M17-Project/Exploded_Mini17/Hardware/EasyEDA/BOM_exploded_mini17_2022-10-17.csv

ID | Name | Designator | Footprint | Quantity | Manufacturer Part | Manufacturer | Supplier | Supplier Part | Price
1 | 15pF | C1,C2 | C0603 | 2 | 0603N150J500CT | Huaxin S&T | LCSC | C302056 | 0.003
2 | 47nF | C3,C4,C5,C6,C7,C8,C9,C10,C11 | C0805 | 9 | CC0805JRX7R7BB473 | YAGEO | LCSC | C520035 | 0.022
3 | 10uF | C12,C25,C57,C59 | CAP-SMD_BD4.0-L4.3-W4.3-LS5.0-FD | 4 | HV100M025B055R | CapXon | LCSC | C59931 | 0.039
4 | 100nF | C13,C14,C16,C24,C26,C36,C37,C38,C39,C40,C41,C42,C43,C46,C49,C50,C51,C52,C53,C56,C58,C60 | C0805 | 22 | 0805B104K500 | WTC | LCSC | C83055 | 0.006
5 | 1uF | C15,C17 | C0805 | 2 | UMK212BJ105KG-T | Taiyo Yuden | LCSC | C319195 | 0.032
6 | 47nF | C18,C19 | C0603 | 2 | 0603F473Z500CT | Huaxin S&T | LCSC | C302047 | 0.015
7 | 56pF | C20 | C0603 | 1 | CGA3E2C0G1H560JT0Y0N | TDK | LCSC | C338104 | 0.019
8 | 100pF | C21 | C0603 | 1 | GRM1885C1H101JA01D | MuRata | LCSC | C71664 | 0.005
9 | 10nF | C22 | C0603 | 1 | GRM188R71H103KA01D | MuRata | LCSC | C77053 | 0.004
10 | 1.5nF | C23 | C0402 | 1 | C1005X7R152KGT | Darfon Elec | LCSC | C147555 | 0.013
11 | 10nF | C27 | C0402 | 1 | GCM155R71H103KA55D | MuRata | LCSC | C91601 | 0.006
12 | 22uF | C28,C45 | CAP-SMD_BD6.3-L6.6-W6.6-FD | 2 | EEEFK1H220P | PANASONIC | LCSC | C128458 | 0.372
13 | 39pF | C29 | C0603 | 1 | TCC0603COG390J500CT | CCTC | LCSC | C376784 | 0.0029
14 | 5.1pF | C30,C31,C35 | C0402 | 3 | GJM1555C1H5R1CB01D | muRata(村田) | LCSC | C882560 | 0.014
15 | 220nF | C32 | C0603 | 1 | 0603B224K250CT | Walsin Tech Corp | LCSC | C335532 | 0.005
16 | 2.2pF | C33 | C0402 | 1 | GCM1555C1H2R2WA16D | Murata Electronics | LCSC | C437438 | 0.045
17 | 6.2pF | C34 | C0402 | 1 | GJM1555C1H6R2DB01D | MuRata | LCSC | C161332 | 0.015
18 | 15pF | C44 | C0805 | 1 | 0805N150J201CT | Walsin Tech Corp | LCSC | C396746 | 0.021
19 | 330nF | C47 | C0805 | 1 | GCM219R71H334KA55D | Murata Electronics | LCSC | C161253 | 0.049
20 | 1nF | C48 | C0805 | 1 | FM21X102K501PXG | PSA(Prosperity Dielectrics) | LCSC | C440004 | 0.008
21 | 2.2uF | C54 | C0805 | 1 | EMK212BJ225KG-T | Taiyo Yuden | LCSC | C319190 | 0.024
22 | 470nF | C55 | C0805 | 1 | 0805B474K500CT | Huaxin S&T | LCSC | C335536 | 0.023
23 | 10pF | C61,C62 | C0805 | 2 | 0805N100J500 | WTC | LCSC | C123640 | 0.007
24 | SUPPLY | CN1 | HDR-TH_2P-P2.54-V-M-1 | 1 | 22-28-4020 | MOLEX | LCSC | C234182 | 0.078
25 | 22-28-4020 | CN2,CN3,CN5 | HDR-TH_2P-P2.54-V-M-1 | 3 | 22-28-4020 | MOLEX | LCSC | C234182 | 0.078
26 | EXT_INT | CN4 | HDR-TH_2P-P2.54-V-M-1 | 1 | 22-28-4020 | MOLEX | LCSC | C234182 | 0.078
27 | EXT_SPK | CN6 | HDR-TH_2P-P2.54-V-M-1 | 1 | 22-28-4020 | MOLEX | LCSC | C234182 | 0.078
28 | EXT_MIC | CN7 | HDR-TH_2P-P2.54-V-M-1 | 1 | 22-28-4020 | MOLEX | LCSC | C234182 | 0.078
29 | BAT60A | D1,D2,D4 | SOD-323_L1.8-W1.3-LS2.5-RD | 3 | BAT60AE6327H | Infineon Technologies | LCSC | C520634 | 0.229
30 | USBLC6-2SC6 | D3 | SOT-23-6_L2.9-W1.6-P0.95-LS2.8-BR | 1 | USBLC6-2SC6 | STMicroelectronics | LCSC | C7519 | 0.205
31 | RF1334-000 | F1 | F1812 | 1 | RF1334-000 | Littelfuse | LCSC | C207187 | 0.243
32 | GPIO | H1,H3 | HDR-TH_5P-P2.54-V-M | 2 | PZ254V-11-05P | XFCN | LCSC | C492404 | 0.028
33 | SWD | H2 | HDR-TH_4P-P2.54-V-M | 1 | X6511WV-04H-C30D60 | XKB Connectivity | LCSC | C706876 | 0.04
34 | GPIO | H4 | HDR-TH_13P-P2.54-V-M | 1 | X6511WV-13H-C30D60 | XKB Connectivity | LCSC | C725945 | 0.231
35 | ANALOG | H5 | HDR-TH_5P-P2.54-V-M | 1 | PZ254V-11-05P | XFCN | LCSC | C492404 | 0.028
36 | GPIO | H6 | HDR-TH_8P-P2.54-V-M | 1 | X6511WV-08H-C30D60 | XKB Connectivity | LCSC | C706880 | 0.122
37 | K2-1102SP-A4SC-04 | BTN1,BTN2,BTN3,RESET | KEY-SMD_4P-L6.0-W6.0-P4.50-LS10.0 | 4 | K2-1102SP-A4SC-04 | HRO | LCSC | C83916 | 0.049
38 | 10uH | L1 | IND-SMD_L3.0-W3.0_LVS303015H-2R2M-N | 1 | LQH3NPN100MJRL | muRata(村田) | LCSC | C668449 | 0.151
39 | 56nH | L2,L3 | L0603 | 2 | MLG1608B56NJT000 | TDK | LCSC | C87538 | 0.023
40 | 15nH | L4,L9 | L0402 | 2 | MLG1005S15NHT000 | TDK | LCSC | C502013 | 0.01
41 | 43nH | L5 | L0402 | 1 | LQW15AN43NG00D | Murata Electronics | LCSC | C167478 | 0.043
42 | 22nH | L6 | L0402 | 1 | LQG15HS22NJ02D | MuRata | LCSC | C12670 | 0.007
43 | 27nH | L7,L8 | L0402-R-RD | 2 | LQW15AN27NH00D | Murata Electronics | LCSC | C113111 | 0.01
44 | GMI4527P-2C-40DB | MIC1 | MIC-TH_BD4.5-P1.60-D0.40-L-FD | 1 | GMI4527P-2C-40db | INGHAi | LCSC | C233329 | 0.359
45 | BSS138 | Q1 | SOT-23-3_L2.9-W1.3-P1.90-LS2.4-BR | 1 | BSS138 | PANJIT(强茂) | LCSC | C2844873 | 0.038
46 | 18Ω | R1 | R0603 | 1 | ERJ3GEYJ180V | PANASONIC | LCSC | C403440 | 0.006
47 | 127kΩ | R2 | R0805 | 1 | WR08X1273FTL | Walsin | LCSC | C170782 | 0.003
48 | 100kΩ | R3,R19 | R0805 | 2 | ERJ6GEYJ104V | PANASONIC | LCSC | C180850 | 0.007
49 | 24K | R4 | R0805 | 1 | CR0805-FX-2402ELF | BOURNS | LCSC | C204332 | 0.014
50 | 56kΩ | R5 | R0603 | 1 | ERJ3GEYJ563V | PANASONIC | LCSC | C400688 | 0.006
51 | 10kΩ | R6,R7,R9,R10,R13,R14,R15,R16,R20,R23 | R0805 | 10 | ERJ6GEYJ103V | PANASONIC | LCSC | C180849 | 0.009
52 | 47kΩ | R8 | R0805 | 1 | ERJ6ENF4702V | PANASONIC | LCSC | C413309 | 0.009
53 | 22kΩ | R11,R12 | R0805 | 2 | ERJ6RBD2202V | PANASONIC | LCSC | C416914 | 0.027
54 | 2.2kΩ | R17 | R0805 | 1 | ERJ6GEYJ222V | PANASONIC | LCSC | C67869 | 0.006
55 | 150kΩ | R18 | R0805 | 1 | AR05DTDW1503 | Viking Tech | LCSC | C319877 | 0.015
56 | 1.2kΩ | R21 | R0805 | 1 | ERJ6ENF1201V | PANASONIC | LCSC | C413281 | 0.012
57 | 5.1kΩ | R22,R25 | R0805 | 2 | ERJ6ENF5101V | PANASONIC | LCSC | C413290 | 0.008
58 | 27Ω | R24,R26 | R0805 | 2 | ARG05FTC0270 | Viking Tech | LCSC | C218474 | 0.011
59 | HJ-SMA405 | RF1 | SMA-TH_BWSMA-KWE-Z001 | 1 | HJ-SMA405 | 皇捷 | LCSC | C2693811 | 1.02
60 | GSPK2307P-8R1W | SPK1 | SPK-TH_BD23.0-P10.00-D0.8-L-RD | 1 | GSPK2307P-8R1W | INGHAi | LCSC | C530531 | 0.852
61 | P70-5000045R | TP1,TP2,TP3,TP4,TP5,TP6 | TESTPOINT-SMD_BD1.5_P70-5000045R | 6 | P70-5000045R | null | LCSC | C9900015296
62 | BLM18AG102SH1D | U1 | L0603 | 1 | BLM18AG102SH1D | Murata Electronics | LCSC | C337877 | 0.017
63 | LDS3985M33R | U2 | SOT-23-5_L3.0-W1.7-P0.95-LS2.8-BL | 1 | LDS3985M33R | STMicroelectronics | LCSC | C222381 | 0.685
64 | CC1200 | U3 | VQFN-32_L5.0-W5.0-P0.50-TL-EP | 1 | CC1200RHBR | TI | LCSC | C122881 | 4.505
65 | TP6841S6 | U4 | SOT-23-6_L2.9-W1.6-P0.95-LS2.8-BL | 1 | TP6841S6 | TECH PUBLIC(台舟) | LCSC | C2844736 | 0.43
66 | GD32F405RGT6 | U5 | LQFP-64_L10.0-W10.0-P0.50-LS12.0-BL | 1 | GD32F405RGT6 | GigaDevice | LCSC | C99031 | 7.459
67 | JUMPER3 | U6,U7,U10 | HDR-TH_3P-P2.54-V-M-A | 3 | Jumper3 | null | LCSC | C2940050
68 | LM4861MX | U8 | SOIC-8_L4.9-W3.9-P1.27-LS6.0-BL | 1 | LM4861MX | TI | LCSC | C7958 | 1.233
69 | MAX9814ETD+T | U9 | TDFN-14_L3.0-W3.0-P0.40-BL-EP | 1 | MAX9814ETD+T | MAXIM | LCSC | C41714 | 2.423
70 | TYPE-C-31-M-12 | USBC1 | USB-C_SMD-TYPE-C-31-M-12 | 1 | TYPE-C-31-M-12 | Rectangular Connectors - Contacts | LCSC | C165948 | 0.226
71 | 40MHz | X1 | CRYSTAL-SMD_4P-L2.0-W1.6-BL-2 | 1 | 9S40000048 | YL(Failong Crystal) | LCSC | C516561 | 0.109
72 | 8MHz | X2 | CRYSTAL-SMD_4P-L3.2-W2.5-BL | 1 | 3225-8.00-20-10-10/A | Suzhou Liming Elec | LCSC | C518156 | 0.341
73 | M3 | XT1,XT2,XT3,XT4 | MOUNTINGHOLE_3.5MM_PAD_VIA | 4
