M17-Project/Exploded_Mini17/Hardware/EasyEDA/exploded_mini17.pdf

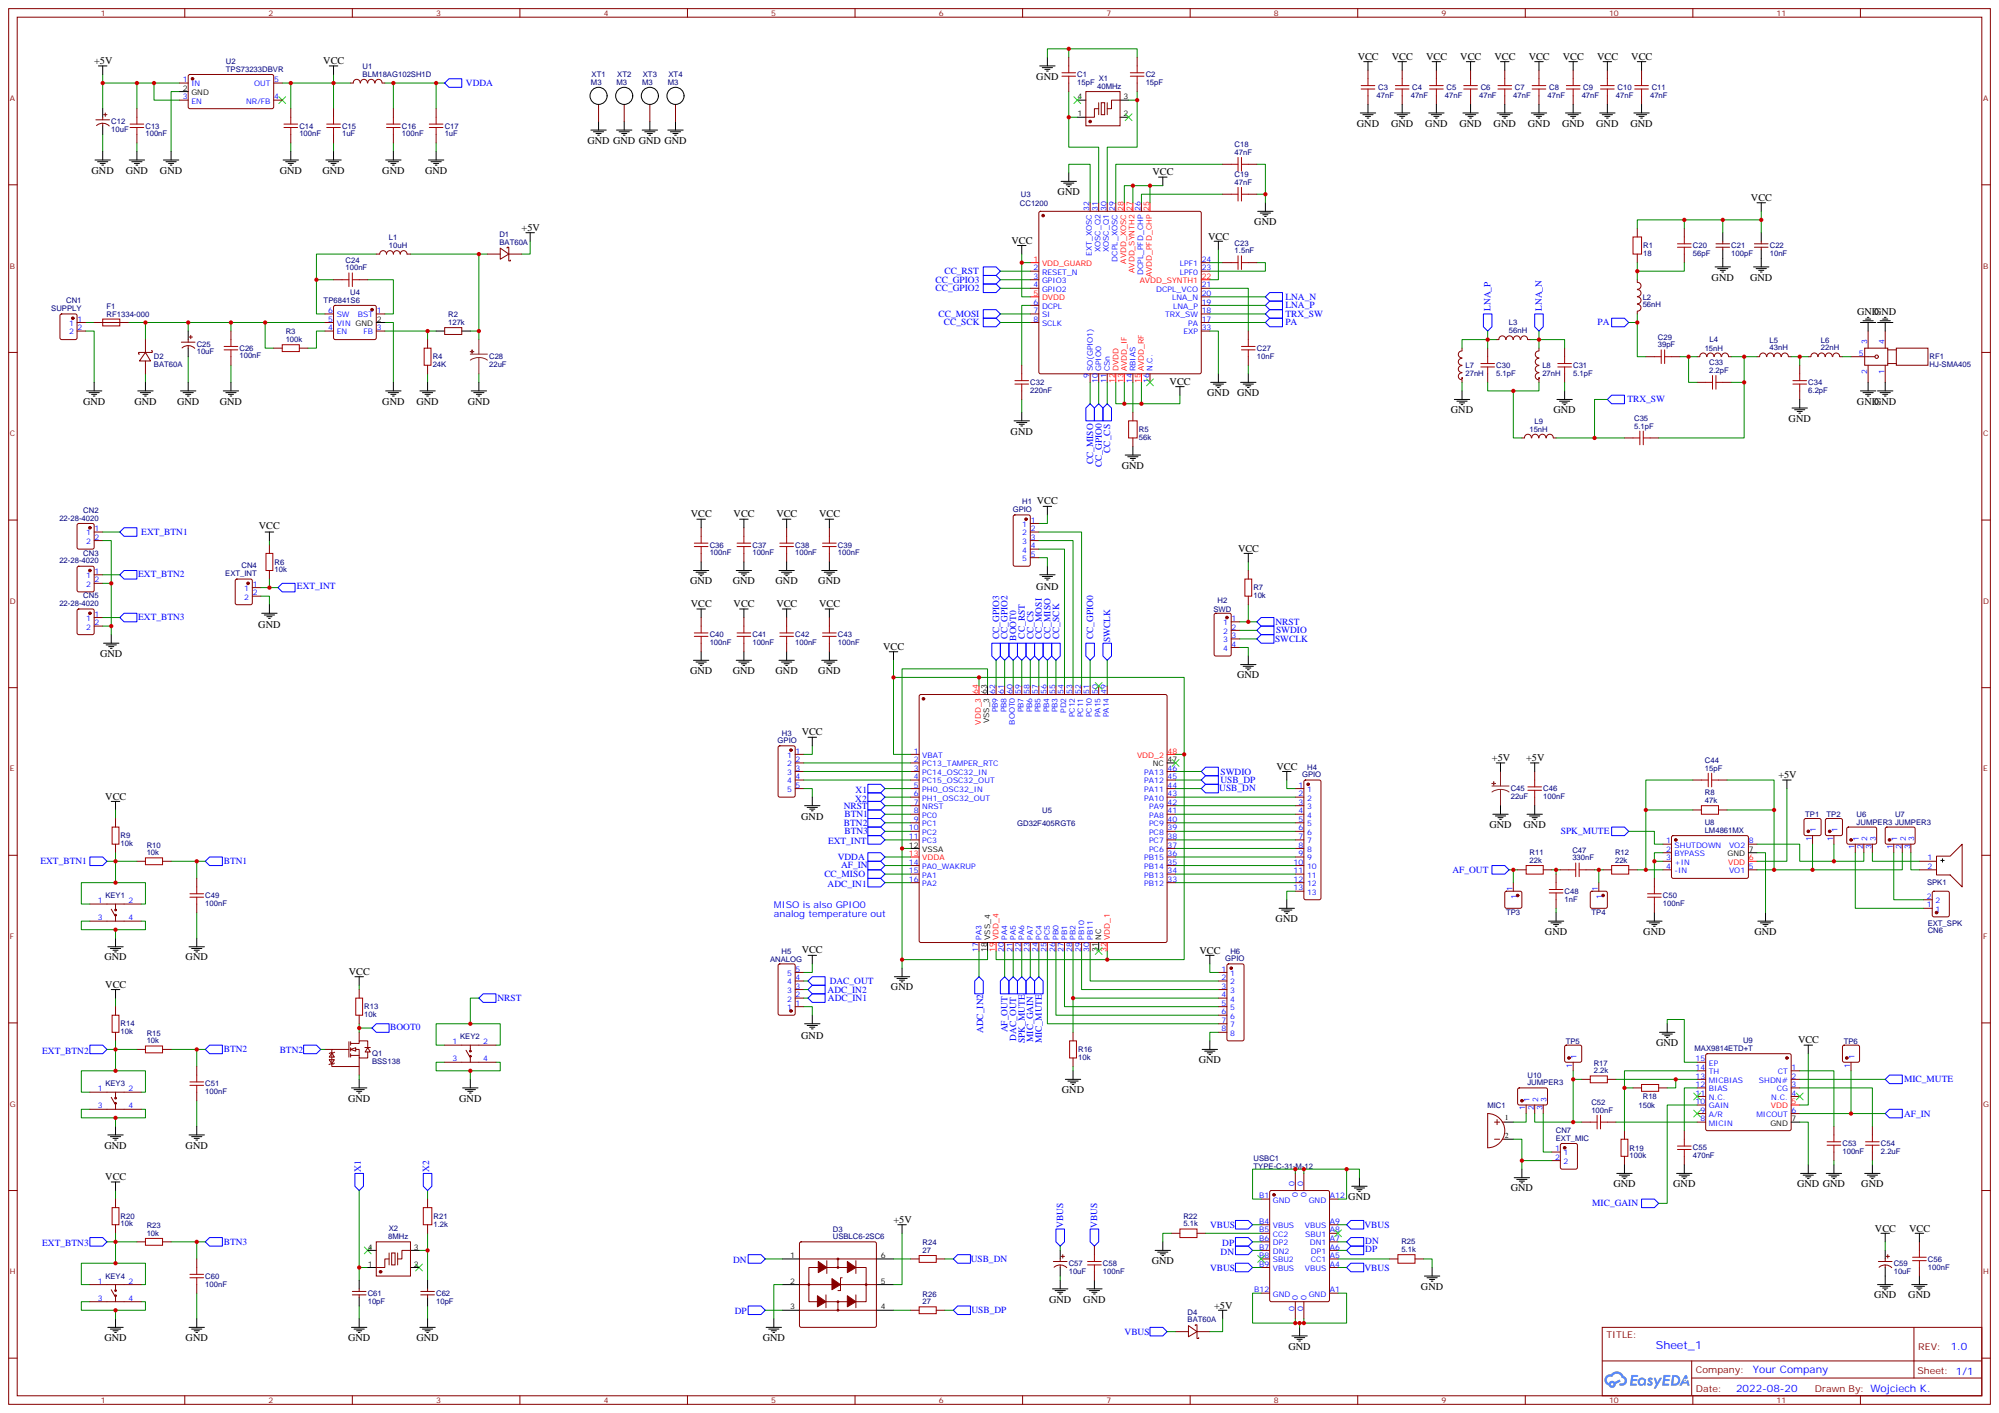
[picture p2: page 1]

VCC VCC VCC VCC VCC VCC VCC VCC VCC

GND GND GND GND

GND GND
