M17-Project/Exploded_Mini17/(list of files, drawings)

Other design files:
Hardware/EasyEDA/exploded_mini17.json
Hardware/EasyEDA/PCB_exploded_mini17.json
