M17-Project/Exploded_Mini17/(threads)

Thread 2 (2022-11-17):

`VCC` shorted out with `GND` below CC1200 [workaround included]

sp5wwp, 2022-11-17:
A few (7) vias short `VCC` and `GND` signals below `U3` (CC1200) on the bottom layer.

sp5wwp, 2022-11-26:
A quick workaround/fix is described [here](https://github.com/M17-Project/Exploded_Mini17#warning).

Closed 2022-11-26.
