M17-Project/Exploded_Mini17/MCU/Core/Src/main.c

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
/* Includes ------------------------------------------------------------------*/
#include "main.h"

/* USER CODE BEGIN Includes */
#include "stream.h"
/* USER CODE END Includes */

ADC_HandleTypeDef hadc1;

DAC_HandleTypeDef hdac;

SPI_HandleTypeDef hspi1;

TIM_HandleTypeDef htim6;

UART_HandleTypeDef huart1;

PCD_HandleTypeDef hpcd_USB_OTG_FS;

/* USER CODE BEGIN PV */
const uint8_t cc1200_rx_settings[50*3] =
{
	0x00, 0x01, 0x08,
	0x00, 0x03, 0x09,
	0x00, 0x08, 0x1F,
    0x00, 0x0A, 0x9F, //RX bw
	0x00, 0x0B, 0x00,
	0x00, 0x0C, 0x5D,
	0x00, 0x0D, 0x00,
	0x00, 0x0E, 0x8A,
	0x00, 0x0F, 0xCB,
	0x00, 0x10, 0xAC,
	0x00, 0x11, 0x00,
	0x00, 0x12, 0x45,
	0x00, 0x13, 0x83, //symbol rate 2 - 24kSa/s
	0x00, 0x14, 0xA9, //symbol rate 1
	0x00, 0x15, 0x2A, //symbol rate 0
	0x00, 0x16, 0x37,
	0x00, 0x17, 0xEC,
	0x00, 0x19, 0x11,
	0x00, 0x1B, 0x51,
	0x00, 0x1C, 0x87,
	0x00, 0x1D, 0x00,
	0x00, 0x20, 0x14,
	0x00, 0x26, 0x03,
	0x00, 0x27, 0x00,
	0x00, 0x28, 0x20,
	0x00, 0x2B, 0x3F,
	0x00, 0x2E, 0xFF,
	0x2F, 0x00, 0x1C,
	0x2F, 0x01, 0x02, //AFC, 0x22 - on, 0x02 - off
	0x2F, 0x05, 0x0D,
	0x2F, 0x0C, 0x57, //freq 435MHz, round((float)435000000/5000000*(1<<16))
	0x2F, 0x0D, 0x00, //freq
	0x2F, 0x0E, 0x00, //freq
	0x2F, 0x10, 0xEE,
	0x2F, 0x11, 0x10,
	0x2F, 0x12, 0x07,
	0x2F, 0x13, 0xAF,
	0x2F, 0x16, 0x40,
	0x2F, 0x17, 0x0E,
	0x2F, 0x19, 0x03,
	0x2F, 0x1B, 0x33,
	0x2F, 0x1D, 0x17,
	0x2F, 0x1F, 0x00,
	0x2F, 0x20, 0x6E,
	0x2F, 0x21, 0x1C,
	0x2F, 0x22, 0xAC,
	0x2F, 0x27, 0xB5,
	0x2F, 0x32, 0x0E,
	0x2F, 0x36, 0x03,
	0x2F, 0x91, 0x08,
};

const uint8_t cc1200_tx_settings[50*3] =
{
	0x00, 0x01, 0x08,
	0x00, 0x03, 0x09,
	0x00, 0x08, 0x1F,
	0x00, 0x0A, 0x59, //deviation
	0x00, 0x0B, 0x01, //deviation, LSB - exponent
	0x00, 0x0C, 0x5D,
	0x00, 0x0D, 0x00,
	0x00, 0x0E, 0x8A,
	0x00, 0x0F, 0xCB,
	0x00, 0x10, 0xAC,
	0x00, 0x11, 0x00,
	0x00, 0x12, 0x45,
	0x00, 0x13, 0x83, //symbol rate 2 - 24kSa/s
	0x00, 0x14, 0xA9, //symbol rate 1
	0x00, 0x15, 0x2A, //symbol rate 0
	0x00, 0x16, 0x37,
	0x00, 0x17, 0xEC,
	0x00, 0x19, 0x11,
	0x00, 0x1B, 0x51,
	0x00, 0x1C, 0x87,
	0x00, 0x1D, 0x00,
	0x00, 0x20, 0x14,
	0x00, 0x26, 0x03,
	0x00, 0x27, 0x00,
	0x00, 0x28, 0x20,
	0x00, 0x2B, 0x05, //power (0x01..0x3F)
	0x00, 0x2E, 0xFF,
	0x2F, 0x00, 0x1C,
	0x2F, 0x01, 0x22,
	0x2F, 0x05, 0x09, //16x upsampler, CFM enable
	0x2F, 0x0C, 0x57, //freq 439M = 0x57CCCD
	0x2F, 0x0D, 0xCC, //freq
	0x2F, 0x0E, 0xCD, //freq
	0x2F, 0x10, 0xEE,
	0x2F, 0x11, 0x10,
	0x2F, 0x12, 0x07,
	0x2F, 0x13, 0xAF,
	0x2F, 0x16, 0x40,
	0x2F, 0x17, 0x0E,
	0x2F, 0x19, 0x03,
	0x2F, 0x1B, 0x33,
	0x2F, 0x1D, 0x17,
	0x2F, 0x1F, 0x00,
	0x2F, 0x20, 0x6E,
	0x2F, 0x21, 0x1C,
	0x2F, 0x22, 0xAC,
	0x2F, 0x27, 0xB5,
	0x2F, 0x32, 0x0E,
	0x2F, 0x36, 0x03,
	0x2F, 0x91, 0x08,
};

uint8_t tx_data[8];
uint8_t rx_data[3]={0,0,0};

volatile uint8_t irq_pend=0;	//baseband sample IRQ
volatile uint8_t mode=0;		//0 - RX, 1- TX

float buff[81];			//look-back buffer for the FIR
uint8_t pushed=0;		//how many samples have we pushed to the buffer
float mac;				//multiply-accumulate result
int8_t sample=0;		//sample value, calculated

uint16_t byte=0;		//byte read from the stream
uint8_t dibit=6;		//dibit ^^ (MSB pair first)
/* USER CODE END PV */

void SystemClock_Config(void);
static void MX_GPIO_Init(void);
static void MX_ADC1_Init(void);
static void MX_DAC_Init(void);
static void MX_SPI1_Init(void);
static void MX_USB_OTG_FS_PCD_Init(void);
static void MX_TIM6_Init(void);
static void MX_USART1_UART_Init(void);
/* USER CODE BEGIN 0 */
void HAL_TIM_PeriodElapsedCallback(TIM_HandleTypeDef *htim)
{
	//HAL_GPIO_TogglePin(TST_PIN_GPIO_Port, TST_PIN_Pin);
	irq_pend=1;
}

void HAL_GPIO_EXTI_Callback(uint16_t GPIO_Pin)
{
	//BTN1
	if(GPIO_Pin==GPIO_PIN_0)
	{
		HAL_GPIO_TogglePin(MIC_MUTE_GPIO_Port, MIC_MUTE_Pin);
	}

	//BTN2
	else if(GPIO_Pin==GPIO_PIN_1)
	{
		HAL_GPIO_TogglePin(SPK_MUTE_GPIO_Port, SPK_MUTE_Pin);
	}

	//BTN3
	else if(GPIO_Pin==GPIO_PIN_2)
	{
		HAL_GPIO_TogglePin(TST_PIN_GPIO_Port, TST_PIN_Pin);
	}
}

void CC1200_Reset(void)
{
	HAL_GPIO_WritePin(SPI1_RST_GPIO_Port, SPI1_RST_Pin, 0);
	HAL_Delay(50);
	HAL_GPIO_WritePin(SPI1_RST_GPIO_Port, SPI1_RST_Pin, 1);
	HAL_Delay(50);

	tx_data[0]=0x30;
	HAL_GPIO_WritePin(SPI1_CS_GPIO_Port, SPI1_CS_Pin, 0);
	HAL_SPI_Transmit(&hspi1, tx_data, 1, 5);
	HAL_GPIO_WritePin(SPI1_CS_GPIO_Port, SPI1_CS_Pin, 1);
}

void CC1200_Init(uint8_t *init_seq)
{
	for(uint8_t i=0; i<50; i++)
	{
		  HAL_GPIO_WritePin(SPI1_CS_GPIO_Port, SPI1_CS_Pin, 0);
		  if(init_seq[i*3])
			  HAL_SPI_Transmit(&hspi1, &init_seq[i*3], 3, 100);
		  else
			  HAL_SPI_Transmit(&hspi1, &init_seq[i*3+1], 2, 100);
		  HAL_GPIO_WritePin(SPI1_CS_GPIO_Port, SPI1_CS_Pin, 1);
		  HAL_Delay(10);
	}
}

void CC1200_Offset(int16_t offset)
{
	tx_data[0]=0x2F|0x40;
	tx_data[1]=0x0A;
	tx_data[2]=*((uint8_t*)&offset+1);
	tx_data[3]=*((uint8_t*)&offset);

	HAL_GPIO_WritePin(SPI1_CS_GPIO_Port, SPI1_CS_Pin, 0);
	HAL_SPI_Transmit(&hspi1, tx_data, 4, 10);
	HAL_GPIO_WritePin(SPI1_CS_GPIO_Port, SPI1_CS_Pin, 1);
}

void CC1200_BurstModeIncr(uint8_t enable)
{
	tx_data[0]=0x2F;
	tx_data[1]=0x06;
	tx_data[2]=enable;

	HAL_GPIO_WritePin(SPI1_CS_GPIO_Port, SPI1_CS_Pin, 0);
	HAL_SPI_Transmit(&hspi1, tx_data, 3, 10);
	HAL_GPIO_WritePin(SPI1_CS_GPIO_Port, SPI1_CS_Pin, 1);
}

void CC1200_RXMode(void)
{
	tx_data[0]=0x34;
	HAL_GPIO_WritePin(SPI1_CS_GPIO_Port, SPI1_CS_Pin, 0);
	HAL_SPI_Transmit(&hspi1, tx_data, 1, 100);
	HAL_GPIO_WritePin(SPI1_CS_GPIO_Port, SPI1_CS_Pin, 1);
}

void CC1200_TXMode(void)
{
	tx_data[0]=0x35;
	HAL_GPIO_WritePin(SPI1_CS_GPIO_Port, SPI1_CS_Pin, 0);
	HAL_SPI_Transmit(&hspi1, tx_data, 1, 100);
	HAL_GPIO_WritePin(SPI1_CS_GPIO_Port, SPI1_CS_Pin, 1);
}

void CC1200_RXStart(void)
{
	tx_data[0]=0x2F|0xC0;
	tx_data[1]=0x7D;
	tx_data[2]=0;

	HAL_GPIO_WritePin(SPI1_CS_GPIO_Port, SPI1_CS_Pin, 0);
	HAL_SPI_TransmitReceive(&hspi1, tx_data, rx_data, 3, 10);
}
void CC1200_TXStart(void)
{
	tx_data[0]=0x2F|0x40;
	tx_data[1]=0x7E;
	tx_data[2]=0;

	HAL_GPIO_WritePin(SPI1_CS_GPIO_Port, SPI1_CS_Pin, 0);
	HAL_SPI_TransmitReceive(&hspi1, tx_data, rx_data, 3, 10);
}

void CC1200_TXRXEnd(void)
{
	HAL_GPIO_WritePin(SPI1_CS_GPIO_Port, SPI1_CS_Pin, 1);
}

//set frequency - burst mode
void CC1200_SetFreq(uint32_t freq)
{
	uint32_t val=(float)freq/5000000*(1<<16);

	tx_data[0]=0x2F|0x40;
	tx_data[1]=0x0C;
	tx_data[2]=(val>>16)&0xFF;
	tx_data[3]=(val>>8)&0xFF;
	tx_data[4]=val&0xFF;

	HAL_GPIO_WritePin(SPI1_CS_GPIO_Port, SPI1_CS_Pin, 0);
	HAL_SPI_Transmit(&hspi1, tx_data, 5, 10);
	HAL_GPIO_WritePin(SPI1_CS_GPIO_Port, SPI1_CS_Pin, 1);
}

//set power (0x01..0x3F)
void CC1200_SetPwr(uint8_t pwr)
{
	tx_data[0]=0x2B;
	tx_data[1]=pwr;

	HAL_GPIO_WritePin(SPI1_CS_GPIO_Port, SPI1_CS_Pin, 0);
	HAL_SPI_Transmit(&hspi1, tx_data, 2, 10);
	HAL_GPIO_WritePin(SPI1_CS_GPIO_Port, SPI1_CS_Pin, 1);
}
/* USER CODE END 0 */

/**
  * @brief  The application entry point.
  * @retval int
  */
int main(void)
{
  /* MCU Configuration--------------------------------------------------------*/

  /* Reset of all peripherals, Initializes the Flash interface and the Systick. */
  HAL_Init();

  /* Configure the system clock */
  SystemClock_Config();

  /* Initialize all configured peripherals */
  MX_GPIO_Init();
  MX_ADC1_Init();
  MX_DAC_Init();
  MX_SPI1_Init();
  MX_USB_OTG_FS_PCD_Init();
  MX_TIM6_Init();
  MX_USART1_UART_Init();
  /* USER CODE BEGIN 2 */
  HAL_Delay(100);

  //chip reset
  CC1200_Reset();
  HAL_Delay(100);

  //TX/RX mode, 0 - RX, 1- TX
  mode=0;

  //chip config
  //CC1200_Init(cc1200_tx_settings);
  CC1200_Init(cc1200_rx_settings);

  //frequency - override the setting in the init sequence
  CC1200_SetFreq(439950000);

  //power - override the setting in the init sequence
  CC1200_SetPwr(0x3C);

  //freq offset compensation
  CC1200_Offset(303);
  HAL_Delay(10);

  //mode - TX/RX
  //CC1200_TXMode();
  CC1200_RXMode();

  //dont increment address in burst mode
  CC1200_BurstModeIncr(0);

  //start write/read burst - tx/rx reg
  //CC1200_TXStart();
  CC1200_RXStart();

  HAL_TIM_Base_Start_IT(&htim6);
  /* USER CODE END 2 */

  /* Infinite loop */
  /* USER CODE BEGIN WHILE */
  while (1)
  {

	  if(irq_pend)
	  {
		  if(mode)//TX
		  {
			  //do the filtering here
			  for(uint8_t i=0; i<41-1; i++)
				  buff[i]=buff[i+1];
			  pushed++;
			  pushed%=5;
			  if(pushed==0)
			  {
				  uint8_t s=(m17_stream[byte]>>dibit)&3;

				  if(s == 0b00)
					  buff[40]=1.0;
				  else if(s == 0b01)
					  buff[40]=3.0;
				  else if(s == 0b10)
					  buff[40]=-1.0;
				  else
					  buff[40]=-3.0;

				  if(dibit>0)
					  dibit-=2;
				  else
				  {
					  dibit=6;
					  byte++;
				  }

				  if(byte==STREAM_SIZE)
					  byte=0;
			  }
			  else
			  {
				  buff[40]=0.0;
			  }

			  mac=0.0;
			  for(uint8_t i=0; i<41; i++)
				  mac+=buff[i]*taps2[i];

			  sample=mac*40.0;

			  HAL_SPI_Transmit(&hspi1, (uint8_t*)&sample, 1, 5);
			  //HAL_UART_Transmit_IT(&huart1, (uint8_t*)&sample, 1);
		  }
		  else //RX
		  {
			  HAL_SPI_TransmitReceive(&hspi1, tx_data, rx_data, 1, 10);
			  //uint16_t s=((int8_t)rx_data[0]+128);
			  //HAL_DAC_SetValue(&hdac, DAC_CHANNEL_1, DAC_ALIGN_12B_R, s);
			  //HAL_DAC_Start(&hdac, DAC_CHANNEL_1);
		  	  HAL_UART_Transmit_IT(&huart1, rx_data, 1);
		  }

		  irq_pend=0;
	  }
    /* USER CODE END WHILE */

    /* USER CODE BEGIN 3 */
  }
  /* USER CODE END 3 */
}

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
