M17-Project/Exploded_Mini17/MCU/Exploded_Mini17.ioc

Mcu.UserName=STM32F405RGTx
PA0-WKUP.GPIO_Label=AF_IN
PA0-WKUP.Signal=ADCx_IN0
PA1.GPIO_Label=ADC_IN0
PA1.Signal=ADCx_IN1
PA10.Signal=USART1_RX
PA11.Signal=USB_OTG_FS_DM
PA12.Signal=USB_OTG_FS_DP
PA13.Signal=SYS_JTMS-SWDIO
PA14.Signal=SYS_JTCK-SWCLK
PA2.GPIO_Label=ADC_IN1
PA2.Signal=ADCx_IN2
PA3.GPIO_Label=ADC_IN2
PA3.Signal=ADCx_IN3
PA4.GPIO_Label=AF_OUT
PA4.Signal=COMP_DAC1_group
PA5.GPIO_Label=DAC_OUT
PA5.Signal=COMP_DAC2_group
PA6.GPIO_Label=SPK_MUTE
PA6.Signal=GPIO_Output
PA7.GPIO_Label=MIC_GAIN
PA7.Signal=GPIO_Output
PA8.GPIO_Label=TST_PIN
PA8.Signal=GPIO_Output
PA9.Signal=USART1_TX
PB3.Signal=SPI1_SCK
PB4.Signal=SPI1_MISO
PB5.Signal=SPI1_MOSI
PB6.GPIO_Label=SPI1_CS
PB6.Signal=GPIO_Output
PB7.GPIO_Label=SPI1_RST
PB7.Signal=GPIO_Output
PB8.GPIO_Label=CC_GPIO2
PB8.Signal=GPXTI8
PB9.GPIO_Label=CC_GPIO3
PB9.Signal=GPXTI9
PC0.GPIO_Label=BTN1
PC0.Signal=GPXTI0
PC1.GPIO_Label=BTN2
PC1.Signal=GPXTI1
PC10.GPIO_Label=CC_GPIO0
PC10.Signal=GPXTI10
PC2.GPIO_Label=BTN3
PC2.Signal=GPXTI2
PC3.GPIO_Label=EXT_INT
PC3.Signal=GPXTI3
PC4.GPIO_Label=MIC_MUTE
PC4.Signal=GPIO_Output
PH0-OSC_IN.Signal=RCC_OSC_IN
PH1-OSC_OUT.Signal=RCC_OSC_OUT
