M17-Project/Exploded_Mini17/MCU/Core/Inc/stream.h

#ifndef STREAM
#define STREAM

#define STREAM_SIZE		39420

const uint8_t m17_stream[STREAM_SIZE]={
        0x77, 0x77, 0x77, 0x77, 0x77, 0x77, 0x77, 0x77, 0x77, 0x77,
        0x77, 0x77, 0x77, 0x77, 0x77, 0x77, 0x77, 0x77, 0x77, 0x77,
        0x77, 0x77, 0x77, 0x77, 0x77, 0x77, 0x77, 0x77, 0x77, 0x77,
        0x77, 0x77, 0x77, 0x77, 0x77, 0x77, 0x77, 0x77, 0x77, 0x77,
        0x77, 0x77, 0x77, 0x77, 0x77, 0x77, 0x77, 0x77, 0x55, 0xF7,
        0x17, 0xFD, 0xEA, 0x51, 0xCA, 0xDE, 0xA4, 0x62, 0xFB, 0x3E,
        0xC6, 0x80, 0xCA, 0xD0, 0xC7, 0x67, 0x4E, 0x8A, 0x1E, 0x47,
        0x95, 0x03, 0xE4, 0x6A, 0x68, 0x33, 0xBB, 0x5C, 0x04, 0xEA,
        0xCA, 0xE2, 0x19, 0x0B, 0xD3, 0x81, 0xF1, 0x17, 0x87, 0x97,
        0xD7, 0x18, 0x6C, 0xE8, 0x18, 0xC2, 0xFF, 0x5D, 0x45, 0xF8,
        0x49, 0x9D, 0xA9, 0xCA, 0xA0, 0x55, 0x59, 0x3F, 0xF4, 0xE3,
        0x19, 0x7B, 0x12, 0x95, 0x63, 0x92, 0x98, 0xBA, 0xE8, 0x21,
        0x42, 0x18, 0x98, 0x7C, 0xC6, 0x69, 0xA6, 0x00, 0x96, 0x08,
        0x56, 0x9A, 0xDA, 0x5F, 0x85, 0xED, 0x5B, 0x95, 0xEB, 0x84,
        0xE2, 0xFC, 0xED, 0x5A, 0xFF, 0x5D, 0x2A, 0xF7, 0xE1, 0x01,
        0xB3, 0xEA, 0xC2, 0xFF, 0x7D, 0x3C, 0x04, 0xA5, 0xC9, 0x9E,
        0x79, 0x3A, 0x00, 0x98, 0x33, 0x87, 0xBC, 0xD5, 0x43, 0x0B,
        0xAF, 0x4D, 0xC5, 0x51, 0xA1, 0x02, 0x6D, 0x3C, 0x0C, 0xFB,
        0xA6, 0x61, 0xA9, 0x61, 0xBD, 0x3F, 0x71, 0x60, 0x30, 0x62,
        0x2D, 0x8D, 0xFF, 0x5D, 0xCF, 0x2B, 0x72, 0x8F, 0x83, 0xE8,
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
     0.008488746155946006,  0.004563508234396922, -0.001077818873364855,
    -0.003889744583281823, -0.002680772347838965,  0.000606339011138998,
     0.003051422479929027,  0.003011674298801149,  0.000978411066065117,
    -0.001227380092907312, -0.002021130037130002
};

#endif
