M17-Project/Exploded_Mini17/(commit log)

2022-10-17 regen BOM, update LDO
    [BOM_exploded_mini17_2022-08-22.csv, BOM_exploded_mini17_2022-10-17.csv, exploded_mini17.json]
2022-10-17 regen PNP file so JLPCB doesn't throw random unhelpful errors
    [PickAndPlace_PCB_exploded_mini17_2022-08-24.csv, PickAndPlace_PCB_exploded_mini17_2022-10-17.csv]
2022-11-07 C29 update
    [BOM_exploded_mini17_2022-10-17.csv]
2022-11-07 updated buttons' part designators
    [BOM_exploded_mini17_2022-10-17.csv]
2022-11-17 Update README.md
    added info on how to fix the board
2022-11-26 Fix #2
    [PCB_exploded_mini17.json]
