M17-Project/Exploded_Mini17/(notices)

Notices in the files:
MCU/Core/Src/main.c:
Copyright (c) 2022 STMicroelectronics.
All rights reserved.
This software is licensed under terms that can be found in the LICENSE file
